mak3r/halloween/fog_coffin/renders/corner_tab_closeup.png

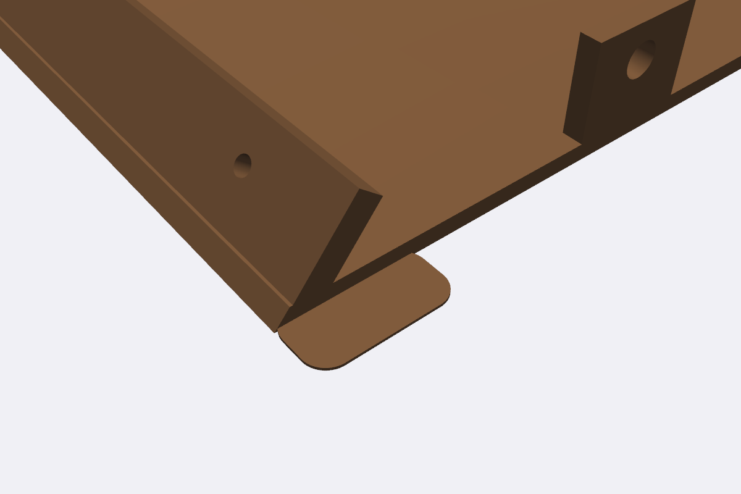
fog_coffin/renders/corner_tab_closeup.png
