mak3r/halloween/fog_coffin/renders/hinge_closeup_tex.png

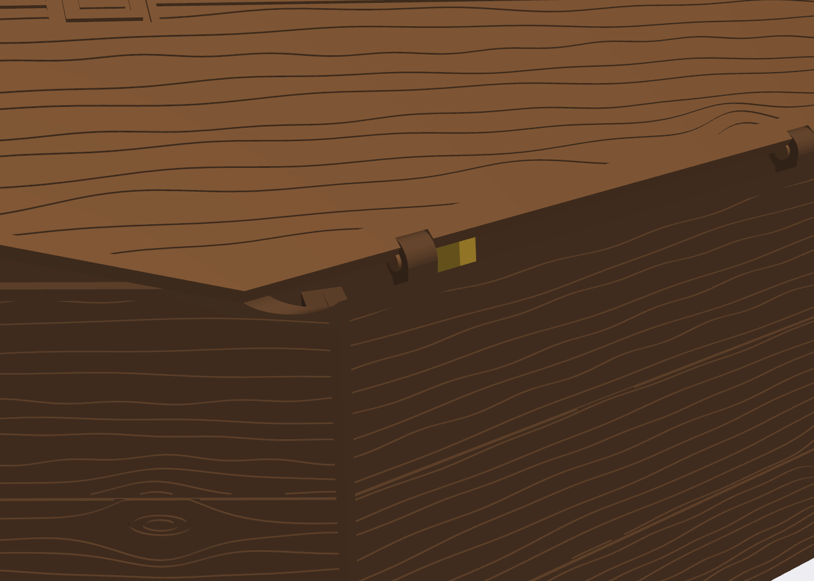
fog_coffin/renders/hinge_closeup_tex.png
