mak3r/halloween/fog_coffin/renders/open55_tex.png

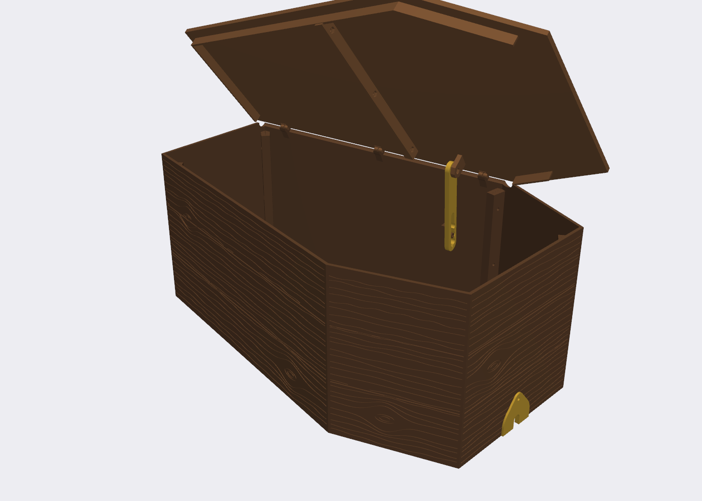
fog_coffin/renders/open55_tex.png
