mak3r/halloween/fog_coffin/renders/open80_inside_tex.png

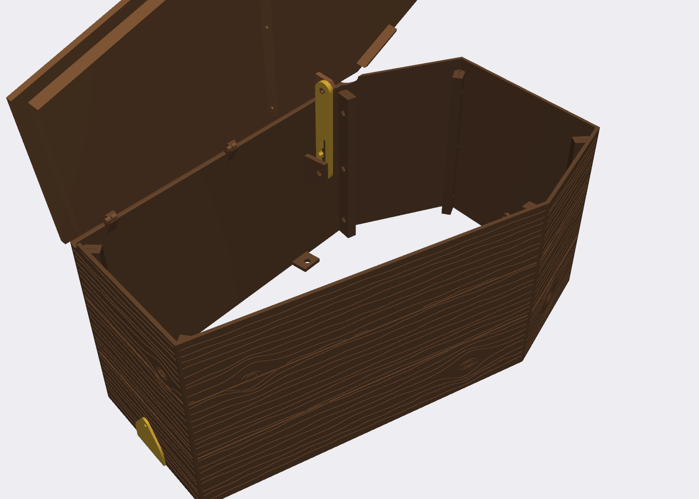
fog_coffin/renders/open80_inside_tex.png
