mak3r/halloween/fog_coffin/step_untextured/fog_coffin_assembly.step

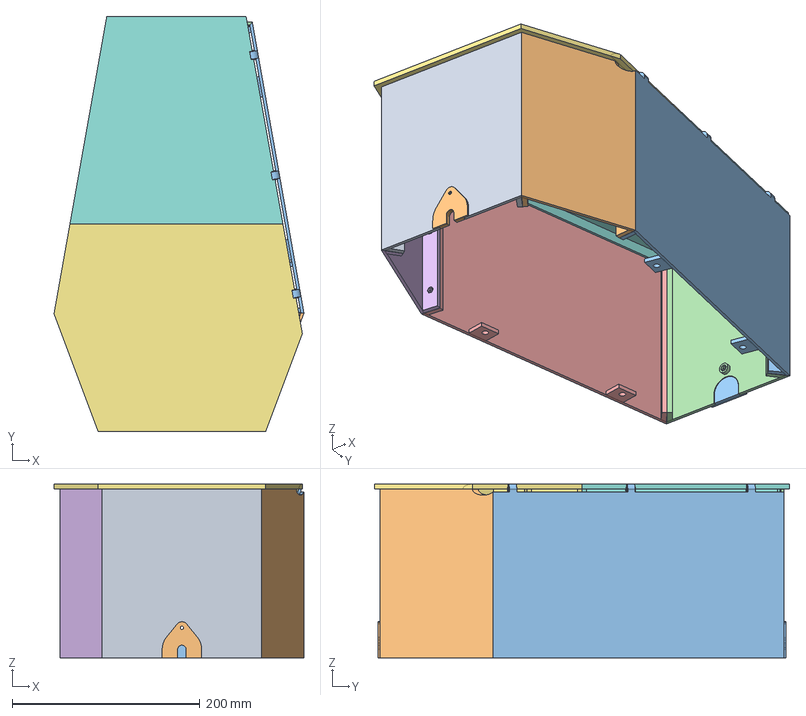
[picture p6: CAD file, 2026-10-19]
fog_coffin/step_untextured/fog_coffin_assembly.step
266.2 x 442.0 x 185.0 mm
wall_0_head
wall_1_right_shoulder
wall_2_right_long_hinge
wall_3_foot
wall_4_left_long
wall_5_left_shoulder
lid_head_half
lid_foot_half
lid_stay
cord_plug_slotted
cord_plug_blank
