mak3r/halloween/fog_coffin/bambu/plate1_hinge_wall_PETG_tuned.3mf

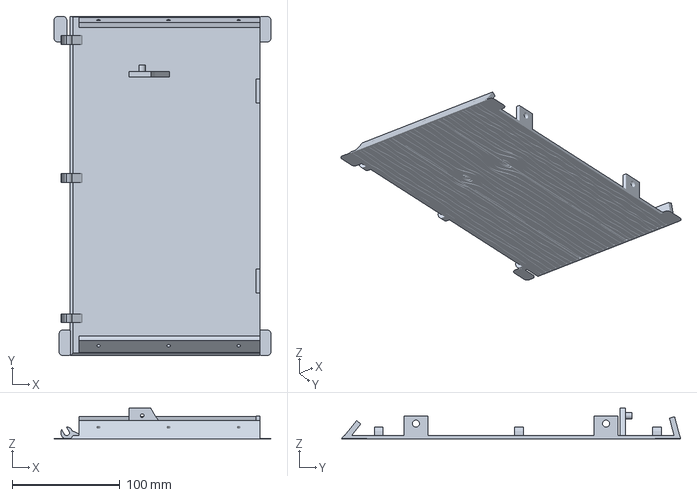
[picture p7: CAD file, 2026-10-19]
fog_coffin/bambu/plate1_hinge_wall_PETG_tuned.3mf
201.3 x 314.8 x 28.5 mm
