mak3r/halloween/fog_coffin/hinge_test_r2/cradle_wall_slot_5.1.stl

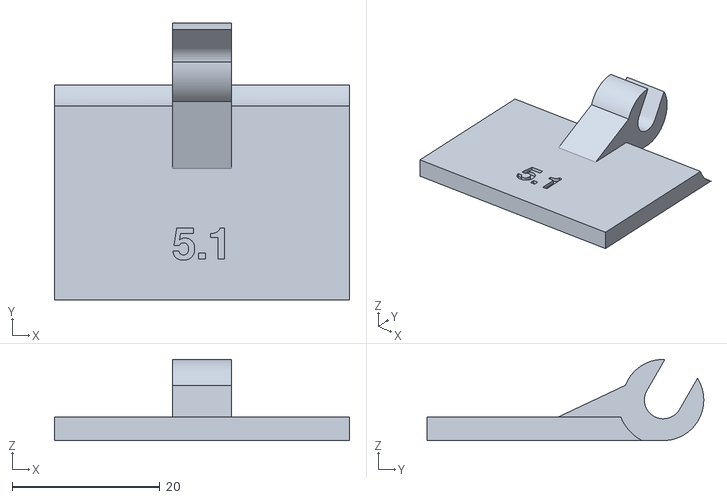
[picture p8: CAD file, 2026-10-19]
fog_coffin/hinge_test_r2/cradle_wall_slot_5.1.stl
40.0 x 37.5 x 11.0
