mak3r/halloween/fog_coffin/plates/plate3_head_wall_and_plugs.3mf

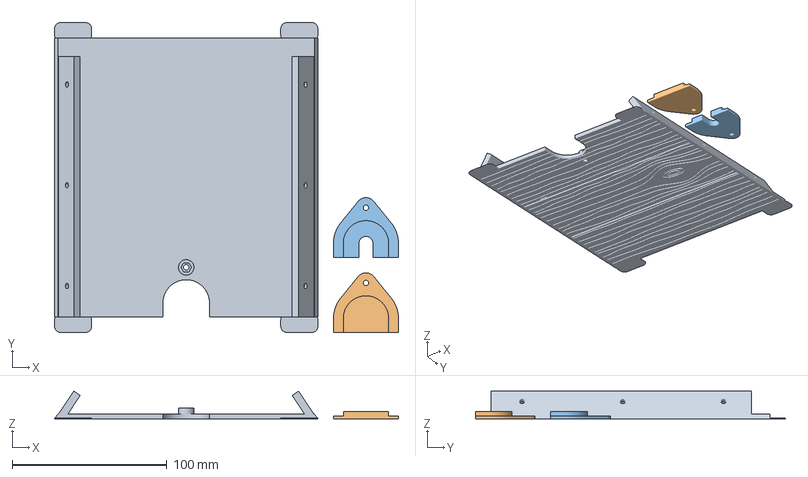
[picture p9: CAD file, 2026-10-19]
fog_coffin/plates/plate3_head_wall_and_plugs.3mf
222.0 x 200.0 x 18.0 mm
wall_0_head
cord_plug_blank
cord_plug_slotted
