mak3r/halloween/fog_coffin/step_untextured/wall_4_left_long.step

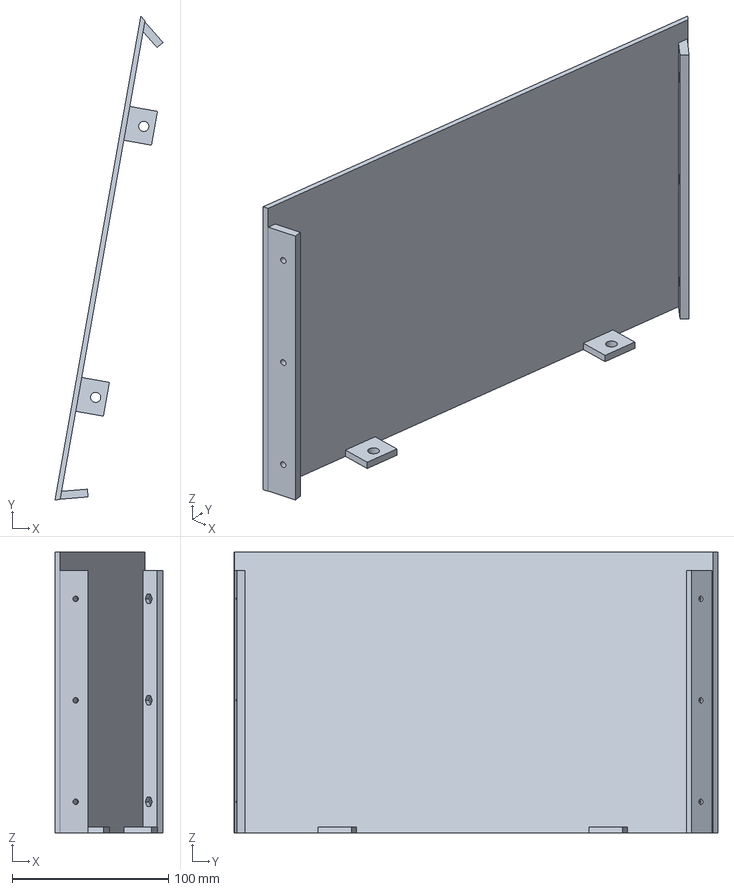
[picture p10: CAD file, 2026-10-19]
fog_coffin/step_untextured/wall_4_left_long.step
69.2 x 310.0 x 180.0 mm
