mak3r/halloween/fog_coffin/stl/wall_1_right_shoulder.stl

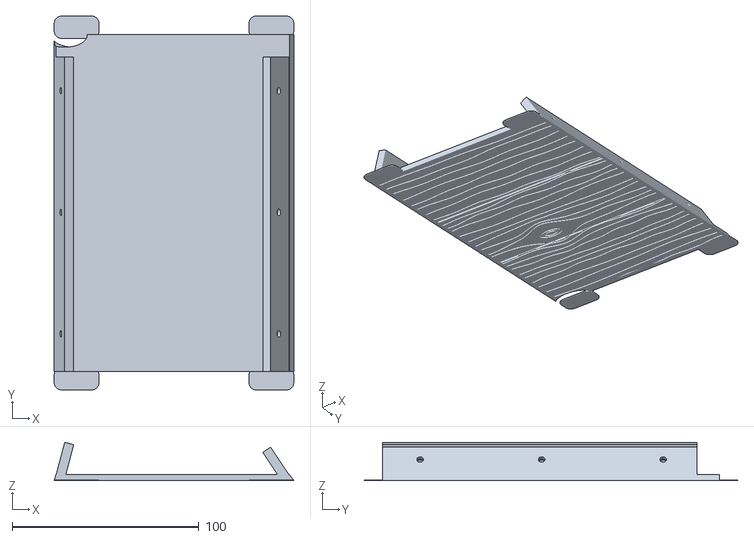
[picture p11: CAD file, 2026-10-19]
fog_coffin/stl/wall_1_right_shoulder.stl
128.2 x 200.0 x 20.6
