mak3r/halloween/fog_coffin/plates/plate7_lid_foot_half.3mf

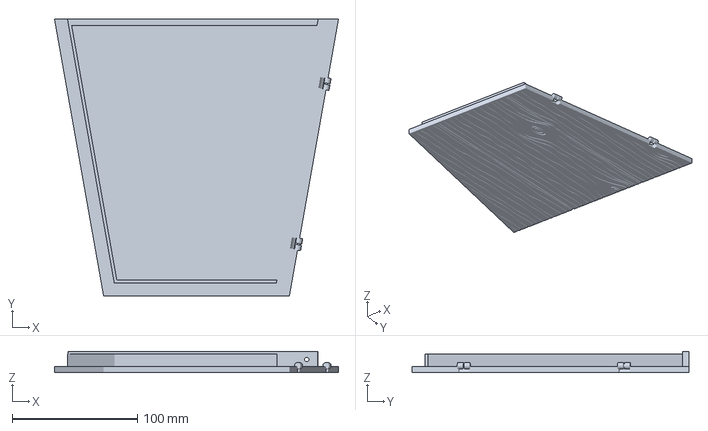
[picture p12: CAD file, 2026-10-19]
fog_coffin/plates/plate7_lid_foot_half.3mf
226.8 x 221.0 x 17.0 mm
