mak3r/halloween/fog_coffin/step_untextured/wall_0_head.step

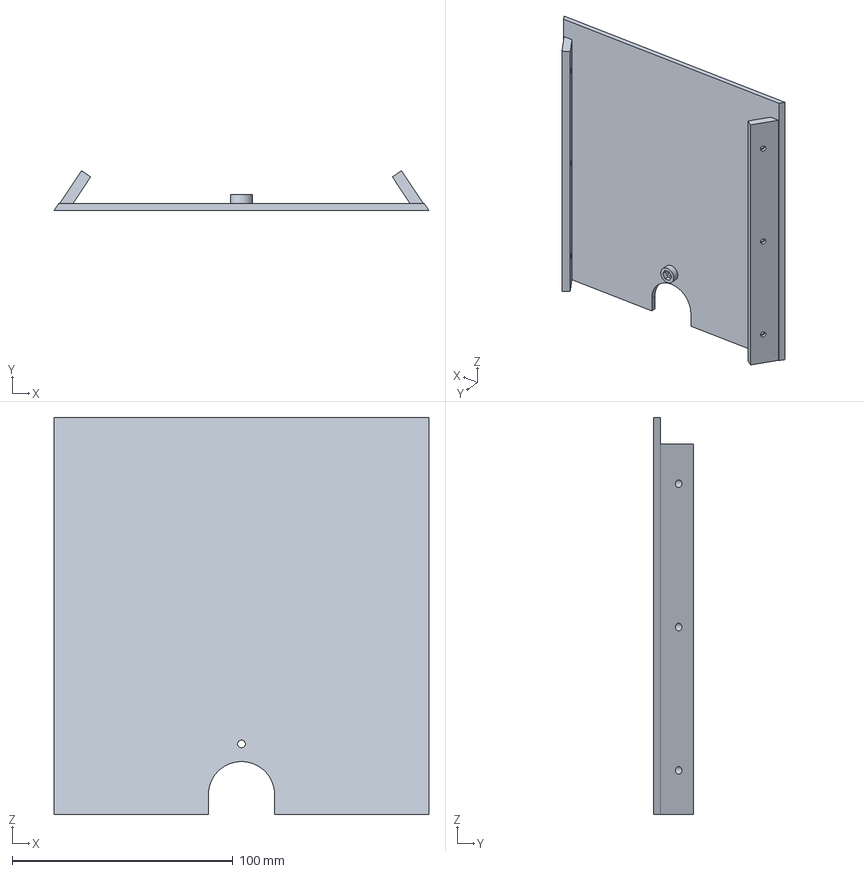
[picture p13: CAD file, 2026-10-19]
fog_coffin/step_untextured/wall_0_head.step
170.0 x 18.0 x 180.0 mm
