mak3r/halloween/fog_coffin/stl/lid_stay.stl

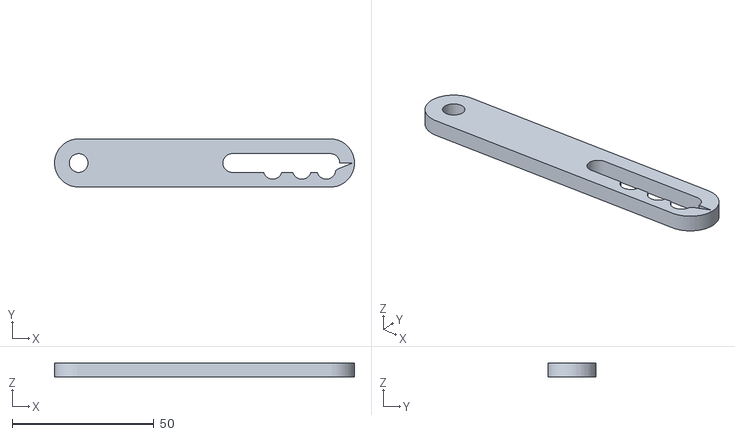
[picture p14: CAD file, 2026-10-19]
fog_coffin/stl/lid_stay.stl
105.7 x 17.0 x 5.00
