mak3r/halloween/fog_coffin/hinge_test_r2/hinge_test_r2_plate.stl

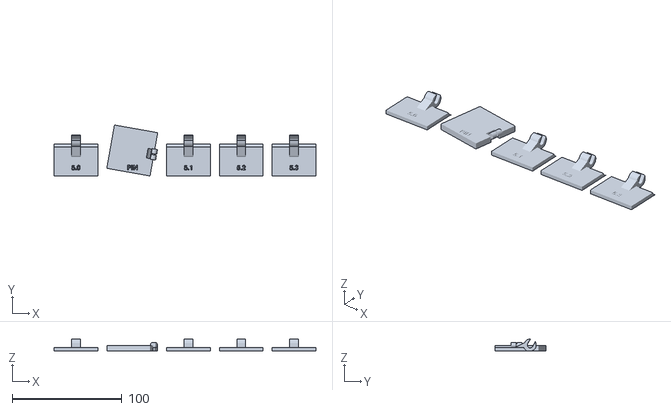
[picture p15: CAD file, 2026-10-19]
fog_coffin/hinge_test_r2/hinge_test_r2_plate.stl
238.4 x 46.4 x 11.0
