mak3r/halloween/fog_coffin/plates/plate2_left_long_wall.3mf

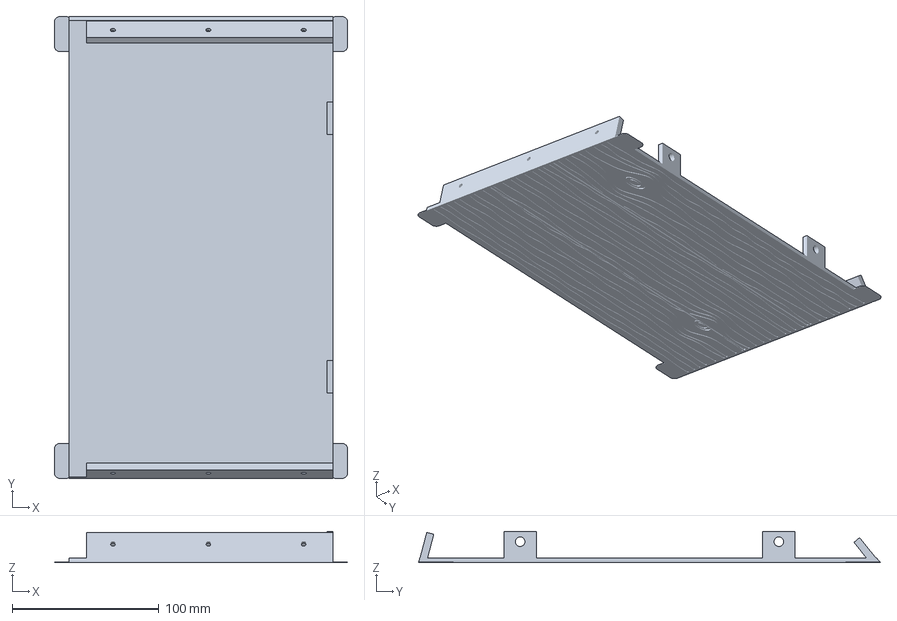
[picture p16: CAD file, 2026-10-19]
fog_coffin/plates/plate2_left_long_wall.3mf
200.0 x 314.8 x 21.2 mm
