mak3r/halloween/fog_coffin/step_untextured/wall_1_right_shoulder.step

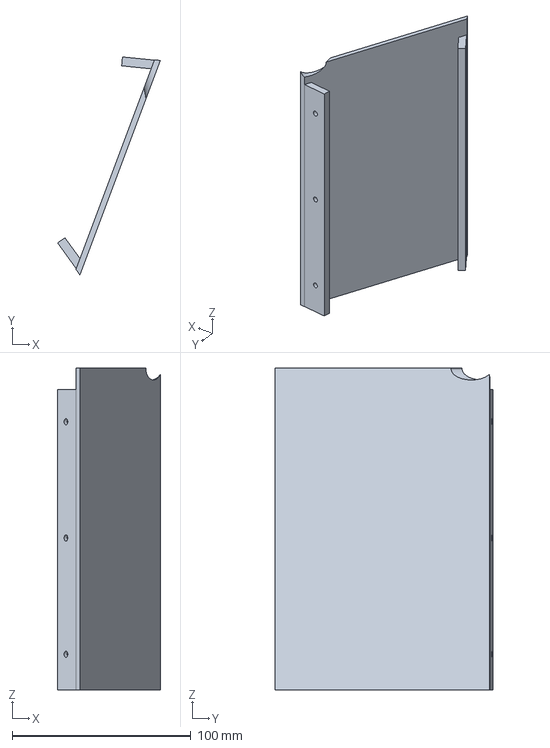
[picture p17: CAD file, 2026-10-19]
fog_coffin/step_untextured/wall_1_right_shoulder.step
57.5 x 121.9 x 180.0 mm
