mak3r/halloween/fog_coffin/plates/plate6_lid_head_half.3mf

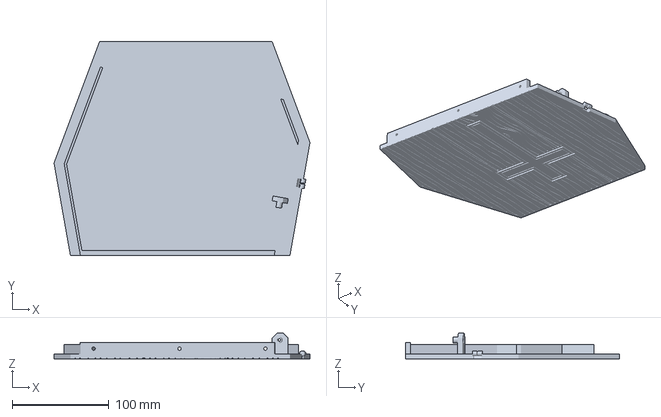
[picture p18: CAD file, 2026-10-19]
fog_coffin/plates/plate6_lid_head_half.3mf
264.5 x 221.0 x 26.5 mm
