mak3r/halloween/fog_coffin/step_untextured/lid_head_half.step

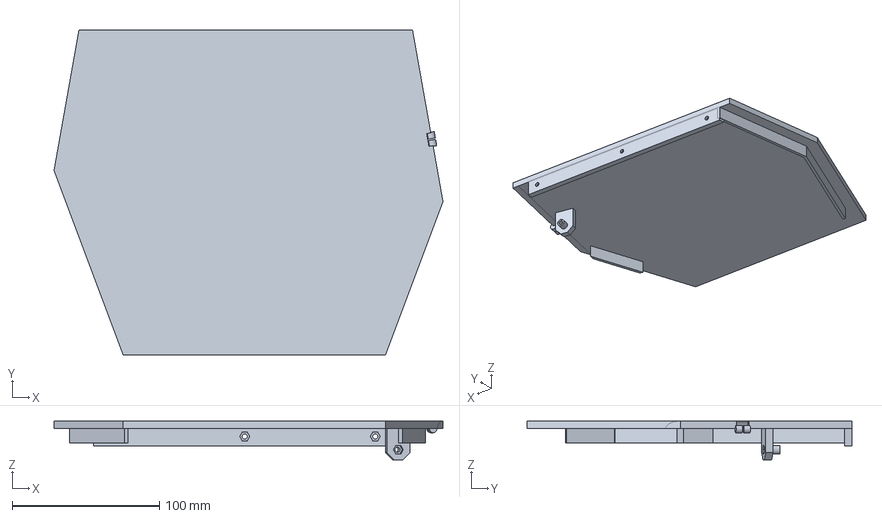
[picture p19: CAD file, 2026-10-19]
fog_coffin/step_untextured/lid_head_half.step
264.5 x 221.0 x 26.5 mm
