mak3r/halloween/fog_coffin/hinge_test_r2/cradle_lid_pins.stl

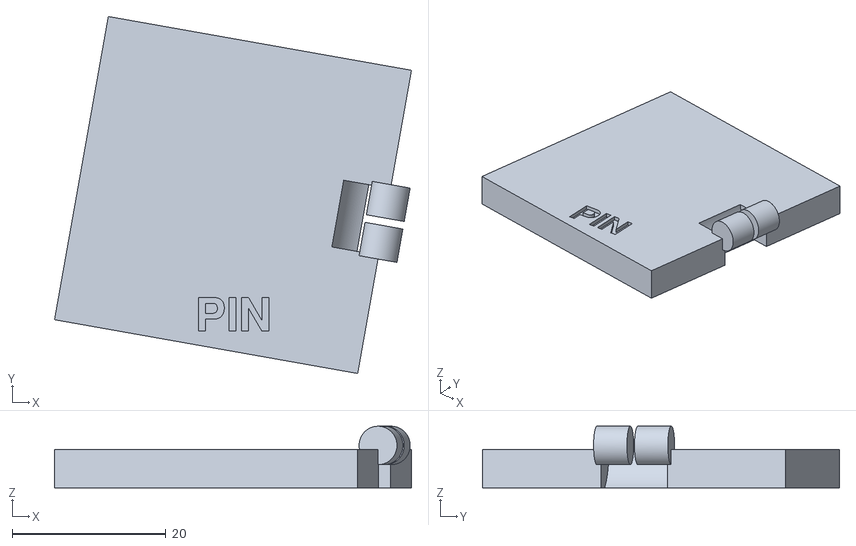
[picture p20: CAD file, 2026-10-19]
fog_coffin/hinge_test_r2/cradle_lid_pins.stl
46.4 x 46.4 x 8.00
