mak3r/halloween/fog_coffin/plates/plate5_shoulder_walls.3mf

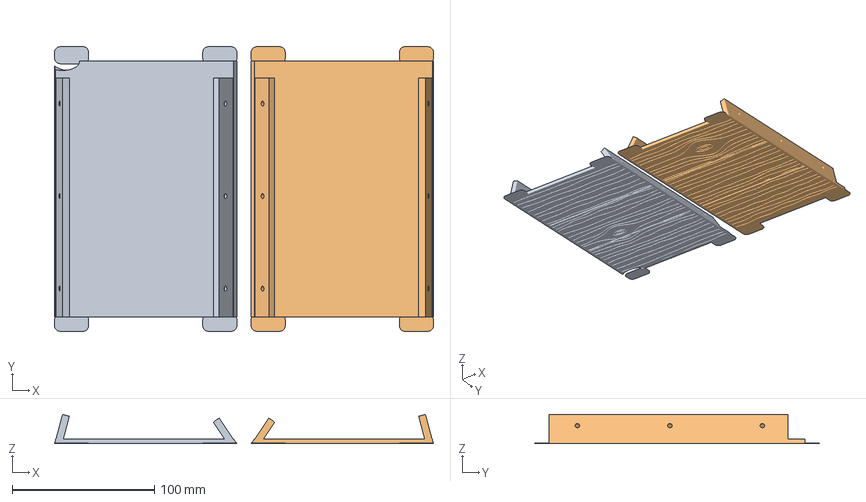
[picture p21: CAD file, 2026-10-19]
fog_coffin/plates/plate5_shoulder_walls.3mf
266.3 x 200.0 x 20.6 mm
wall_1_right_shoulder
wall_5_left_shoulder
