mak3r/halloween/fog_coffin/stl/cord_plug_slotted.stl

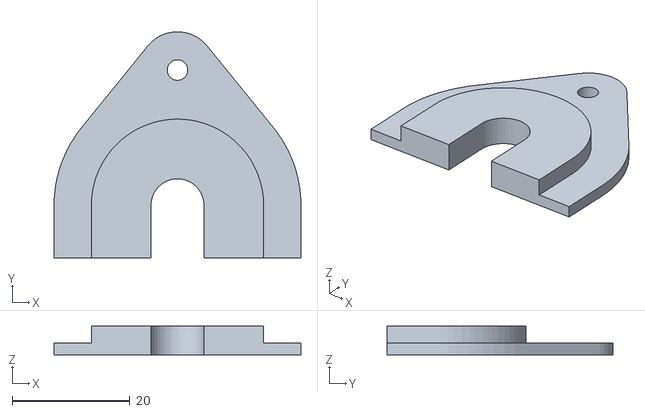
[picture p22: CAD file, 2026-10-19]
fog_coffin/stl/cord_plug_slotted.stl
42.0 x 38.5 x 4.90
