mak3r/halloween/fog_coffin/stl/wall_3_foot.stl

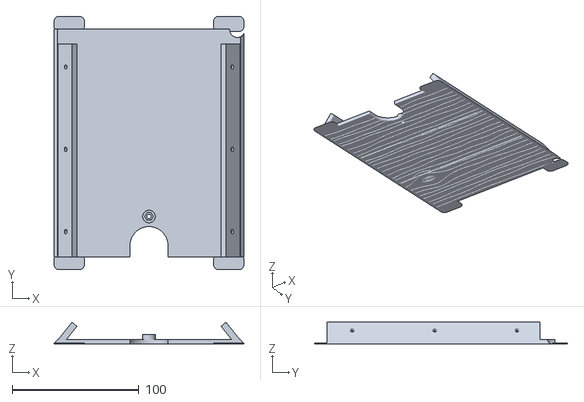
[picture p23: CAD file, 2026-10-19]
fog_coffin/stl/wall_3_foot.stl
150.0 x 200.0 x 17.0
