mak3r/halloween/fog_coffin/plates/plate4_foot_wall_and_stay.3mf

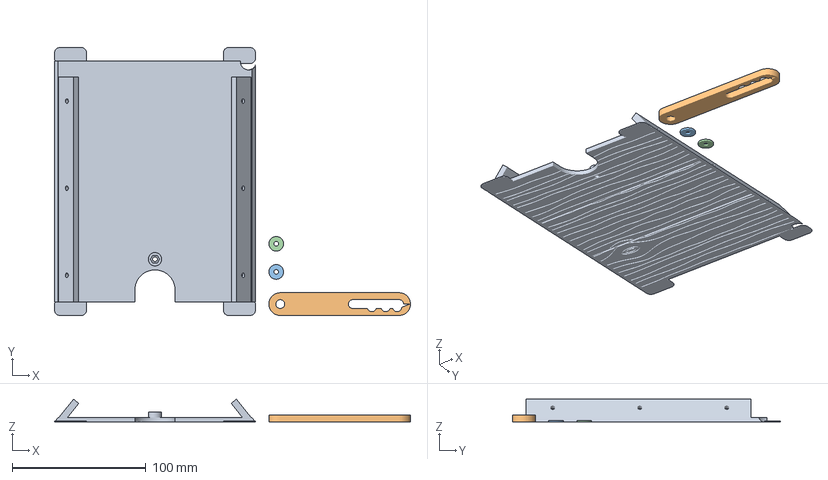
[picture p24: CAD file, 2026-10-19]
fog_coffin/plates/plate4_foot_wall_and_stay.3mf
265.7 x 200.0 x 17.0 mm
wall_3_foot
lid_stay
stay_washer_a
stay_washer_b
