mak3r/halloween/fog_coffin/step_untextured/cord_plug_blank.step

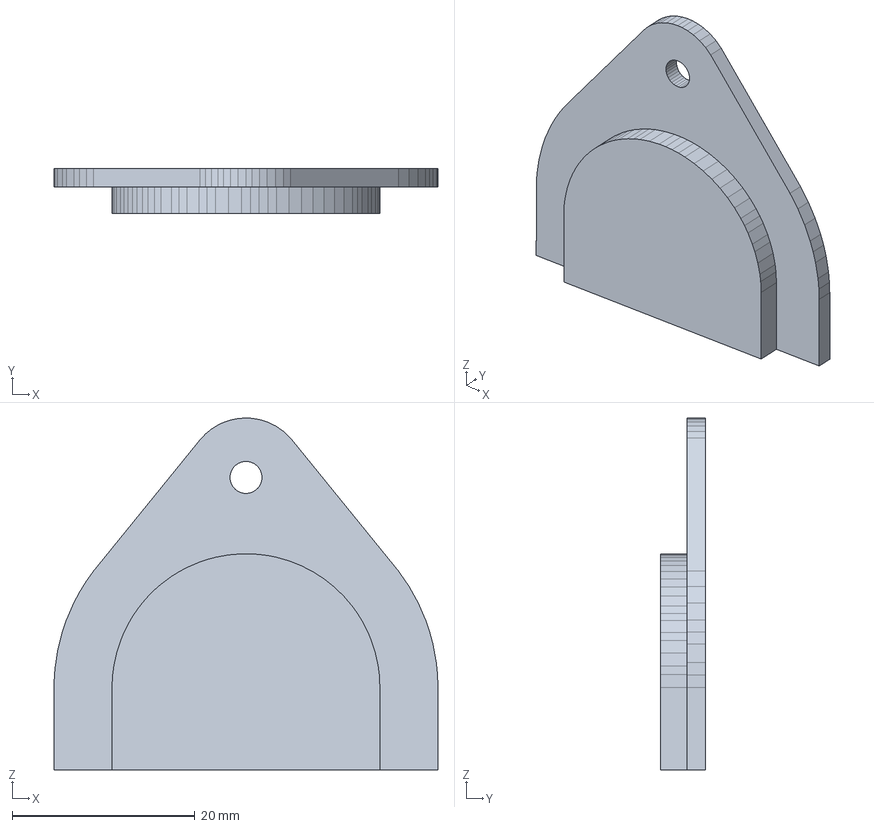
[picture p25: CAD file, 2026-10-19]
fog_coffin/step_untextured/cord_plug_blank.step
42.0 x 4.90 x 38.5 mm
