mak3r/halloween/fog_coffin/stl/wall_0_head.stl

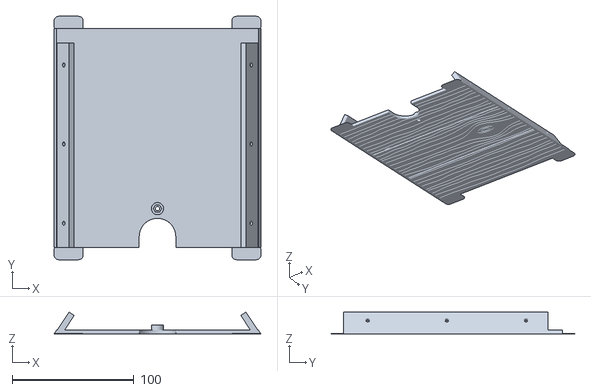
[picture p26: CAD file, 2026-10-19]
fog_coffin/stl/wall_0_head.stl
170.0 x 200.0 x 18.0
