mak3r/halloween/fog_coffin/step_untextured/lid_stay.step

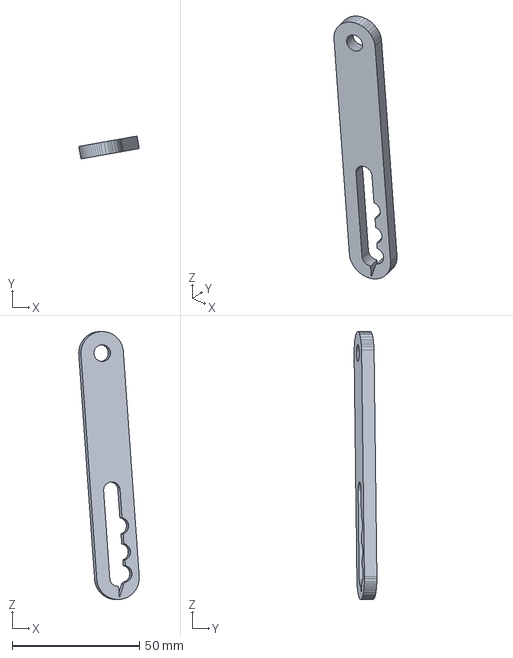
[picture p27: CAD file, 2026-10-19]
fog_coffin/step_untextured/lid_stay.step
23.8 x 9.00 x 105.5 mm
