mak3r/halloween/fog_coffin/step_untextured/lid_foot_half.step

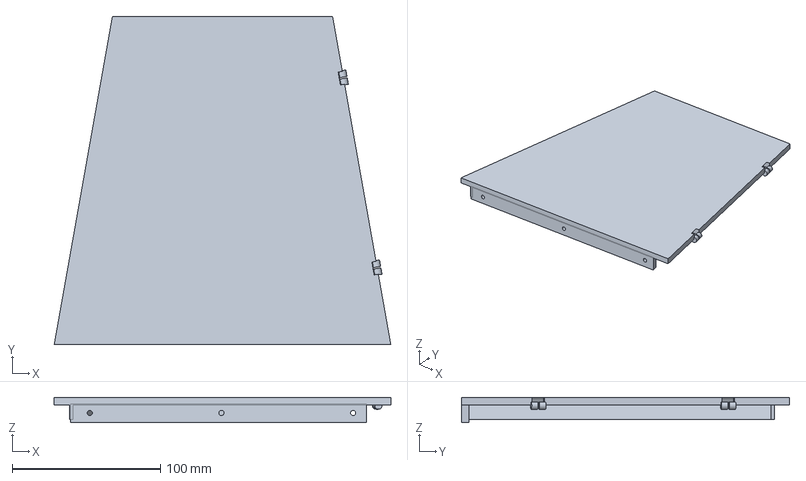
[picture p28: CAD file, 2026-10-19]
fog_coffin/step_untextured/lid_foot_half.step
226.8 x 221.0 x 17.0 mm
