mak3r/halloween/fog_coffin/step_untextured/wall_3_foot.step

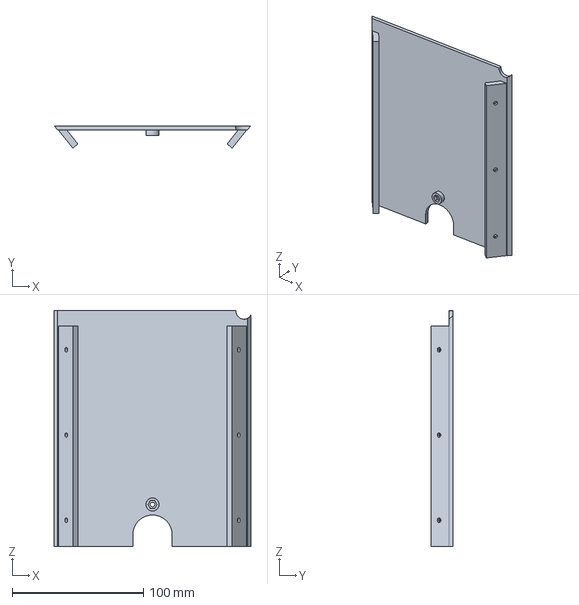
[picture p29: CAD file, 2026-10-19]
fog_coffin/step_untextured/wall_3_foot.step
150.0 x 17.0 x 180.0 mm
