mak3r/halloween/(list of files, cad)

Other CAD files:
fog_coffin/hinge_test_r2/cradle_wall_slot_5.3.stl
fog_coffin/stl/wall_4_left_long.stl
fog_coffin/hinge_test_r2/cradle_wall_slot_5.2.stl
fog_coffin/stl/lid_foot_half.stl
fog_coffin/hinge_test_r2/cradle_wall_slot_5.0.stl
fog_coffin/plates/plate1_right_long_hinge_wall.3mf
fog_coffin/step_untextured/wall_5_left_shoulder.step
fog_coffin/step_untextured/cord_plug_slotted.step
fog_coffin/stl/lid_head_half.stl
fog_coffin/step_untextured/wall_2_right_long_hinge.step
fog_coffin/stl/wall_5_left_shoulder.stl
fog_coffin/stl/wall_2_right_long_hinge.stl
fog_coffin/stl/cord_plug_blank.stl
fog_coffin/stl/stay_washer_a.stl
fog_coffin/stl/stay_washer_b.stl
