mak3r/halloween/fog_coffin/hinge_test_r2/hinge_test_plate.png

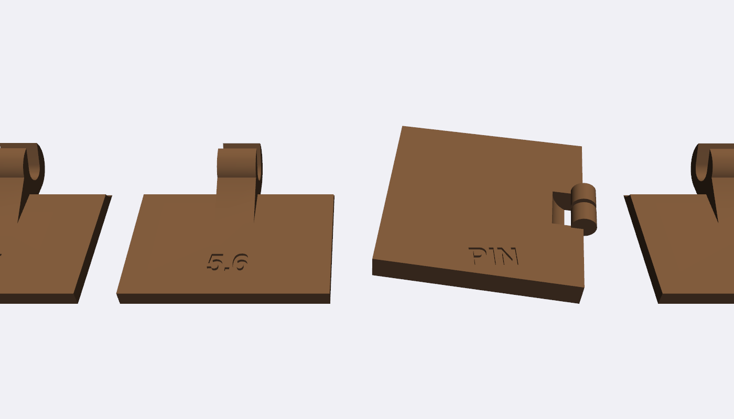
fog_coffin/hinge_test_r2/hinge_test_plate.png
