mak3r/halloween/(commit log)

2026-10-19 Snapshot of fog coffin folder as of Oct 19 (rev 5 design, incl. hand-tuned plate 1 project)
    Claude-Session: https://claude.ai/code/session_01BV2mQDadHbAkN1tLvjg36h
    [cord_plug_blank.step, cord_plug_blank.stl, cord_plug_slotted.step, cord_plug_slotted.stl, cradle_lid_pins.stl, cradle_wall_slot_5.0.stl, cradle_wall_slot_5.1.stl, cradle_wall_slot_5.2.stl]
2026-10-19 Keep tuned Bambu project separate; refresh renders and notes
    - Move the hand-tuned plate 1 Bambu Studio project (with slicer settings)
    to fog_coffin/bambu/ so export.py can never overwrite it
    - plates/plate1 is again the generated, settings-free layout
    - Document the tuned settings in the README
    - Refresh renders, add round-2 hinge test plate image
    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
    [plate1_hinge_wall_PETG_tuned.3mf, plate1_right_long_hinge_wall.3mf]
2026-10-19 Add licenses, top-level README; scripts write next to themselves
    - Designs: CC BY-NC-SA 4.0; code: PolyForm Noncommercial 1.0.0
    - export.py / hinge_test.py now regenerate the tracked folders in place
    instead of writing to ./out
    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
2026-10-19 Generate plates as Bambu Studio projects with the tuned settings
    Add bambu3mf.py: builds plates/*.3mf from stl/*.stl using
    fog_coffin/bambu/plate1_hinge_wall_PETG_tuned.3mf as the settings
    template. Slicer settings are copied byte-for-byte; only the parts are
    replaced, so every plate opens ready to slice instead of with the
    'invalid config, load geometry only' warning. export.py now calls it.
    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
    [plate1_right_long_hinge_wall.3mf, plate2_left_long_wall.3mf, plate3_head_wall_and_plugs.3mf, plate4_foot_wall_and_stay.3mf, plate5_shoulder_walls.3mf, plate6_lid_head_half.3mf, plate7_lid_foot_half.3mf]
2026-10-19 Add assembly guide and corner-joint map
    - fog_coffin/ASSEMBLY.md: parts and hardware list, how the corner
    flanges work, which wall takes the nuts at each corner (A-F), build
    order, tightening, cord plugs, lid seam, hanging the lid, fitting the
    stay, set-up and take-down
    - renders/assembly_map.png drawn from the model by assembly_diagram.py
    - README assembly section now points to the guide
    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
2026-10-19 Use global PETG 'BEST' preset in the template; regenerate plates
    Template re-saved in Bambu Studio with the user's saved filament preset
    (now embedded as Metadata/filament_settings_1.config) instead of a
    project-only copy. Plates rebuilt from it.
    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
    [plate1_hinge_wall_PETG_tuned.3mf, plate1_right_long_hinge_wall.3mf, plate2_left_long_wall.3mf, plate3_head_wall_and_plugs.3mf, plate4_foot_wall_and_stay.3mf, plate5_shoulder_walls.3mf, plate6_lid_head_half.3mf, plate7_lid_foot_half.3mf]
